OzmoOzmo/CastleAritechArduinoESP32/HowTo/ArdTx Final Soln V2_CustomLib.asc

0-3.3V: signal; PULSE(0 3.3 0 .000001 .000001 .0006 .0012 100)
0-12V: signal; PULSE(0 12 0 .000001 .000001 0.0006 .0012 10000)
C1: cap; 10nF
Q1: NPN; BC109C
Q3: npn; BC109C
R3: res; 22K; tol=1 pwr=0.1
R4: res; 2K; tol=1 pwr=0.1
R6: res; 15K; tol=1 pwr=0.1
R7: res; 4.7K; tol=1 pwr=0.1
R8: res; 1.5K; tol=1 pwr=0.1
R9: res; 4.7K; tol=1 pwr=0.1
R10: res; 4K7; tol=1 pwr=0.1
V1: voltage; 12V
V2: voltage; 3.3V
Named nets: A_12V, 0, EspTx_Pin15, D_PnlTx, RKP_Bus_D_Tx, EspRx_Pin13, RKP_Bus_C_RX, 3.3V, B_0V, RKP_Bus_A_12V, RKP_Bus_0V
.tran 10m startup
Line Resistance
(c)2015 "Ozmo" - Boards.ie
Free to use anywhere once above line appears somewhere
 
Alarm Panel 4 Wire Connector
========================
RKP_Bis_A = +12 Volts (Aprox)
RKP_Bis_B = GND (Connect to Esp32 Gnd)
RKP_Bis_C_RX = Panel Communcations
RKP_Bis_D_TX = Panel Communcations
 
12V supplied from panel to power
3.3V ESP32 via DC-DC stepdown module.
ESP32 Pins:
==========
Pin13= Serial RX
Pin15 = Serial TX
GND = Common GND of circuit
