OzmoOzmo/CastleAritechArduinoESP32/CastleAritechArduinoESP32/OLEDDisplay.cpp

/**
 * Greatly reduced code for LCD display - Based on code found on https://thingpulse.com
 *
 */

#include "OLEDDisplay.h"
#include <Wire.h>

OLEDDisplay::OLEDDisplay(uint8_t _address, uint8_t _sda, uint8_t _scl)
{
    this->_address = _address;
    this->_sda = _sda;
    this->_scl = _scl;
}

OLEDDisplay::~OLEDDisplay() {
}

bool OLEDDisplay::init()
{
    if (!this->connect()) {
        //DEBUG_OLEDDISPLAY("[OLEDDISPLAY][init] Can't establish connection to display\n");
        return false;
    }

  sendInitCommands();
  resetDisplay();

  return true;
}

void OLEDDisplay::resetDisplay(void) {
  clear();
  display();
}

void OLEDDisplay::drawString(int16_t xMove, int16_t yMove, String strUser)
{
    const char* text = strUser.c_str();
    uint16_t textLength = strlen(text);
    
    uint8_t textHeight = pgm_read_byte(fontData + HEIGHT_POS);
    uint8_t firstChar = pgm_read_byte(fontData + FIRST_CHAR_POS);
    uint16_t sizeOfJumpTable = pgm_read_byte(fontData + CHAR_NUM_POS) * JUMPTABLE_BYTES;

    uint16_t cursorX = 0;
    uint16_t cursorY = 0;

    for (uint16_t j = 0; j < textLength; j++) {
        int16_t xPos = xMove + cursorX;
        int16_t yPos = yMove + cursorY;

        uint8_t code = text[j];
        if (code >= firstChar) {
            uint8_t charCode = code - firstChar;

            // 4 Bytes per char code
            uint8_t msbJumpToChar = pgm_read_byte(fontData + JUMPTABLE_START + charCode * JUMPTABLE_BYTES);                  // MSB  \ JumpAddress
            uint8_t lsbJumpToChar = pgm_read_byte(fontData + JUMPTABLE_START + charCode * JUMPTABLE_BYTES + JUMPTABLE_LSB);   // LSB /
            uint8_t charByteSize = pgm_read_byte(fontData + JUMPTABLE_START + charCode * JUMPTABLE_BYTES + JUMPTABLE_SIZE);  // Size
            uint8_t currentCharWidth = pgm_read_byte(fontData + JUMPTABLE_START + charCode * JUMPTABLE_BYTES + JUMPTABLE_WIDTH); // Width

            // Test if the char is drawable
            if (!(msbJumpToChar == 255 && lsbJumpToChar == 255)) {
                // Get the position of the char data
                uint16_t charDataPosition = JUMPTABLE_START + sizeOfJumpTable + ((msbJumpToChar << 8) + lsbJumpToChar);
                drawInternal(xPos, yPos, currentCharWidth, textHeight, fontData, charDataPosition, charByteSize);
            }

            cursorX += currentCharWidth;
        }
    }
}

void OLEDDisplay::flipScreenVertically() {
  sendCommand(SEGREMAP | 0x01);
  sendCommand(COMSCANDEC);           //Rotate screen 180 Deg
}

void OLEDDisplay::clear(void) {
  memset(buffer, 0, displayBufferSize);
}

void OLEDDisplay::sendInitCommands(void) {
  sendCommand(DISPLAYOFF);
  sendCommand(SETDISPLAYCLOCKDIV);
  sendCommand(0xF0); // Increase speed of the display max ~96Hz
  sendCommand(SETMULTIPLEX);
  sendCommand(displayHeight - 1);
  sendCommand(SETDISPLAYOFFSET);
  sendCommand(0x00);
  sendCommand(SETSTARTLINE);
  sendCommand(CHARGEPUMP);
  sendCommand(0x14);
  sendCommand(MEMORYMODE);
  sendCommand(0x00);
  sendCommand(SEGREMAP);
  sendCommand(COMSCANINC);
  sendCommand(SETCOMPINS);
  sendCommand(0x02); //GEOMETRY_128_32
  sendCommand(SETCONTRAST);
  sendCommand(0x8F); //GEOMETRY_128_32
  sendCommand(SETPRECHARGE);
  sendCommand(0xF1);
  sendCommand(SETVCOMDETECT); //0xDB, (additionally needed to lower the contrast)
  sendCommand(0x40);	        //0x40 default, to lower the contrast, put 0
  sendCommand(DISPLAYALLON_RESUME);
  sendCommand(NORMALDISPLAY);
  sendCommand(0x2e);            // stop scroll
  sendCommand(DISPLAYON);
}

void inline OLEDDisplay::drawInternal(int16_t xMove, int16_t yMove, int16_t width, int16_t height, const uint8_t *data, uint16_t offset, uint16_t bytesInData) {
  if (width < 0 || height < 0) return;
  if (yMove + height < 0 || yMove > displayHeight)  return;
  if (xMove + width  < 0 || xMove > displayWidth)   return;

  uint8_t  rasterHeight = 1 + ((height - 1) >> 3); // fast ceil(height / 8.0)
  int8_t   yOffset      = yMove & 7;

  bytesInData = bytesInData == 0 ? width * rasterHeight : bytesInData;

  int16_t initYMove   = yMove;
  int8_t  initYOffset = yOffset;

  for (uint16_t i = 0; i < bytesInData; i++) {

    // Reset if next horizontal drawing phase is started.
    if ( i % rasterHeight == 0) {
      yMove   = initYMove;
      yOffset = initYOffset;
    }

    uint8_t currentByte = pgm_read_byte(data + offset + i);

    int16_t xPos = xMove + (i / rasterHeight);
    int16_t yPos = ((yMove >> 3) + (i % rasterHeight)) * displayWidth;

    int16_t dataPos    = xPos  + yPos;

    if (dataPos >=  0  && dataPos < displayBufferSize &&
        xPos    >=  0  && xPos    < displayWidth ) {

      if (yOffset >= 0) {
        buffer[dataPos] |= currentByte << yOffset; // WHITE

        if (dataPos < (displayBufferSize - displayWidth)) {
          buffer[dataPos + displayWidth] |= currentByte >> (8 - yOffset); // WHITE:   
         }
      } else {
        // Make new offset position
        yOffset = -yOffset;

         buffer[dataPos] |= currentByte >> yOffset; //]case WHITE: 

        // Prepare for next iteration by moving one block up
        yMove -= 8;

        // and setting the new yOffset
        yOffset = 8 - yOffset;
      }
    }
  }
}

inline void OLEDDisplay::sendCommand(uint8_t command)
{
    Wire.beginTransmission(_address);
    Wire.write(0x80);
    Wire.write(command);
    Wire.endTransmission();
}

bool OLEDDisplay::connect()
{
    Wire.begin(this->_sda, this->_scl);
    // Let's use ~700khz if ESP8266 is in 160Mhz mode
    // this will be limited to ~400khz if the ESP8266 in 80Mhz mode.
    Wire.setClock(700000);
    return true;
}

void OLEDDisplay::display(void)
{
    const int x_offset = (128 - displayWidth) / 2;
    sendCommand(COLUMNADDR);
    sendCommand(x_offset);
    sendCommand(x_offset + (displayWidth - 1));

    sendCommand(PAGEADDR);
    sendCommand(0x0);

    sendCommand(0x3); //GEOMETRY_128_32

    for (uint16_t i = 0; i < displayBufferSize; i++) {
        Wire.beginTransmission(this->_address);
        Wire.write(0x40);
        for (uint8_t x = 0; x < 16; x++) {
            Wire.write(buffer[i]);
            i++;
        }
        i--;
        Wire.endTransmission();
    }
}


uint8_t OLEDDisplay::fontData[]{
  0x0A, // Width: 10
  0x0D, // Height: 13
  0x20, // First Char: 32
  0xE0, // Numbers of Chars: 224

  // Jump Table:
  0xFF, 0xFF, 0x00, 0x03,  // 32:65535
  0x00, 0x00, 0x04, 0x03,  // 33:0
  0x00, 0x04, 0x05, 0x04,  // 34:4
  0x00, 0x09, 0x09, 0x06,  // 35:9
  0x00, 0x12, 0x0A, 0x06,  // 36:18
  0x00, 0x1C, 0x10, 0x09,  // 37:28
  0x00, 0x2C, 0x0E, 0x07,  // 38:44
  0x00, 0x3A, 0x01, 0x02,  // 39:58
  0x00, 0x3B, 0x06, 0x03,  // 40:59
  0x00, 0x41, 0x06, 0x03,  // 41:65
  0x00, 0x47, 0x05, 0x04,  // 42:71
  0x00, 0x4C, 0x09, 0x06,  // 43:76
  0x00, 0x55, 0x04, 0x03,  // 44:85
  0x00, 0x59, 0x03, 0x03,  // 45:89
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
  0x00,0x00,0xF8,0x03,0x48,0x02,0x48,0x02,0x48,0x02,0x48,0x02,  // 69
  0x00,0x00,0xF8,0x03,0x48,0x00,0x48,0x00,0x08, // 70
  0x00,0x00,0xE0,0x00,0x10,0x01,0x08,0x02,0x48,0x02,0x50,0x01,0xC0, // 71
  0x00,0x00,0xF8,0x03,0x40,0x00,0x40,0x00,0x40,0x00,0xF8,0x03,  // 72
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
};
