OzmoOzmo/CastleAritechArduinoESP32/CastleAritechArduinoESP32/OLEDDisplay.h

/**
 * The MIT License (MIT)
 *
 * Copyright (c) 2018 by ThingPulse, Daniel Eichhorn
 * Copyright (c) 2018 by Fabrice Weinberg
 * Copyright (c) 2019 by Helmut Tschemernjak - www.radioshuttle.de
 *
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
 * ThingPulse invests considerable time and money to develop these open source libraries.
 * Please support us by buying our products (and not the clones) from
 * https://thingpulse.com
 *
 */

#ifndef OLEDDISPLAY_h
#define OLEDDISPLAY_h

#include <Arduino.h>

#ifndef DEBUG_OLEDDISPLAY
#define DEBUG_OLEDDISPLAY(...)
#endif

// Header Values
#define JUMPTABLE_BYTES 4

#define JUMPTABLE_LSB   1
#define JUMPTABLE_SIZE  2
#define JUMPTABLE_WIDTH 3
#define JUMPTABLE_START 4

#define WIDTH_POS 0
#define HEIGHT_POS 1
#define FIRST_CHAR_POS 2
#define CHAR_NUM_POS 3


// Display commands
#define CHARGEPUMP 0x8D
#define COLUMNADDR 0x21
#define COMSCANDEC 0xC8
#define COMSCANINC 0xC0
#define DISPLAYALLON 0xA5
#define DISPLAYALLON_RESUME 0xA4
#define DISPLAYOFF 0xAE
#define DISPLAYON 0xAF
#define EXTERNALVCC 0x1
#define INVERTDISPLAY 0xA7
#define MEMORYMODE 0x20
#define NORMALDISPLAY 0xA6
#define PAGEADDR 0x22
#define SEGREMAP 0xA0
#define SETCOMPINS 0xDA
#define SETCONTRAST 0x81
#define SETDISPLAYCLOCKDIV 0xD5
#define SETDISPLAYOFFSET 0xD3
#define SETHIGHCOLUMN 0x10
#define SETLOWCOLUMN 0x00
#define SETMULTIPLEX 0xA8
#define SETPRECHARGE 0xD9
#define SETSEGMENTREMAP 0xA1
#define SETSTARTLINE 0x40
#define SETVCOMDETECT 0xDB
#define SWITCHCAPVCC 0x2

#ifndef _swap_int16_t
#define _swap_int16_t(a, b) { int16_t t = a; a = b; b = t; }
#endif

#define displayWidth 128
#define displayHeight 32
#define displayBufferSize (128 * 32 / 8)

#include <Wire.h>

typedef unsigned char uint8_t;

class OLEDDisplay {

public:

    OLEDDisplay(uint8_t _address, uint8_t _sda, uint8_t _scl);
    
    ~OLEDDisplay();

    // Draws a string at the given location
    void drawString(int16_t x, int16_t y, String text);

    // Turn the display upside down
    void flipScreenVertically();

    // Write the buffer to the display memory
    void display(void);

    // Clear the local pixel buffer
    void clear(void);

    bool init();

protected:
    void resetDisplay(void);

    uint8_t buffer[displayBufferSize];

    static uint8_t fontData[];

    // Send a command to the display (low level function)
    void sendCommand(uint8_t com);

    // Send all the init commands
    void sendInitCommands();

    void inline drawInternal(int16_t xMove, int16_t yMove, int16_t width, int16_t height, const uint8_t *data, uint16_t offset, uint16_t bytesInData) __attribute__((always_inline));

    bool connect();
private:
    uint8_t             _address;
    uint8_t             _sda;
    uint8_t             _scl;
};

#endif
