OzmoOzmo/CastleAritechArduinoESP32/(commit log)

2018-03-21 Added Electronics Schematics
2021-01-24 Working version for ESP32 Boards.
2021-02-01 ESP32 Internet Interface for Aritech Panels - Added Alexa Support
2021-03-09 Updated some docs
    Added photos and board layout
2021-04-07 Board layout
2024-02-06 Fix for esp32 SDK 2.0.14
    [RKP.cpp]
